inputlabs/alpakka_pcb/alpakka.kicad_pcb

## KiCad design alpakka.kicad_pcb (2023-12-26)

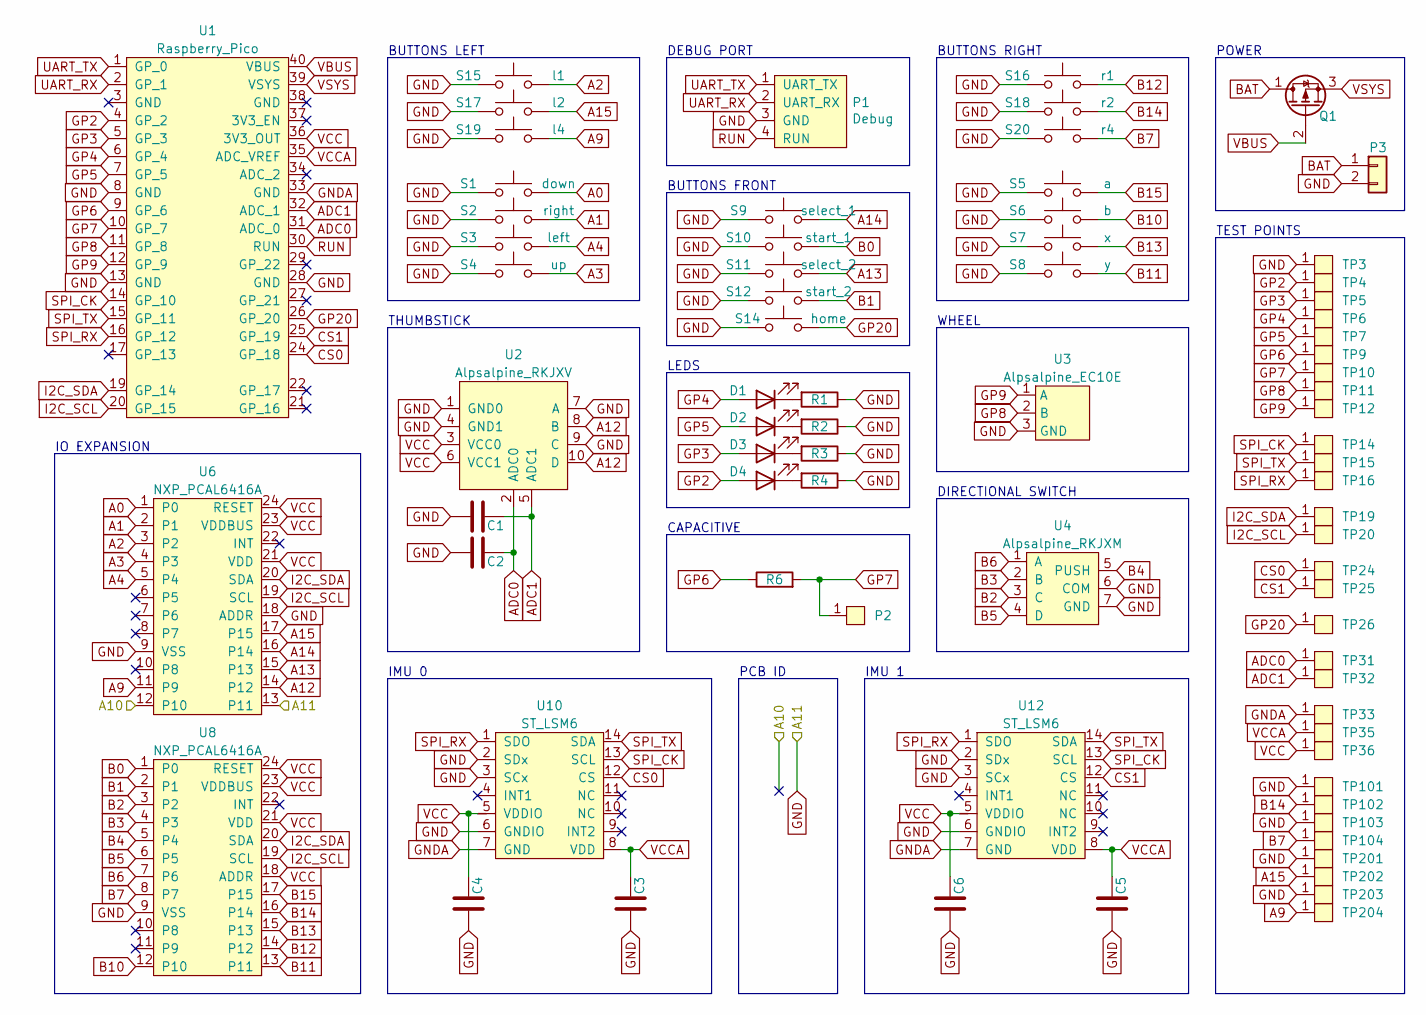
[picture p1: schematic alpakka.kicad_sch]

Parts:
C1, C2, C3, C4, C5, C6: C; 0402; LCSC C1525
D1, D2, D3, D4: Diode; 0603_d; LCSC C2290
P1: Debug; JST_S4B-PH-SM4-K-TB; LCSC C265332
P2: Endpoint; HRO_BC-25-3P; LCSC C707322
P3: Conn_01x02; JST_PH_2_TH
Q1: Q_PMOS_DGS; SOT-23-DGS
R1, R2, R3, R4: R; 0603; LCSC C22950
R6: R6; 0402; LCSC C11616
S1: down; Alpsalpine_SKPM; LCSC C115348
S2: right; Alpsalpine_SKPM; LCSC C115348
S3: left; Alpsalpine_SKPM; LCSC C115348
S4: up; Alpsalpine_SKPM; LCSC C115348
S5: a; Alpsalpine_SKPM; LCSC C115348
S6: b; Alpsalpine_SKPM; LCSC C115348
S7: x; Alpsalpine_SKPM; LCSC C115348
S8: y; Alpsalpine_SKPM; LCSC C115348
S9: select_1; Alpsalpine_SKPM; LCSC C115348
S10: start_1; Alpsalpine_SKPM; LCSC C115348
S11: select_2; Alpsalpine_SKPM; LCSC C115348
S12: start_2; Alpsalpine_SKPM; LCSC C115348
S14: home; Alpsalpine_SKPM; LCSC C115348
S15: l1; Alpsalpine_SKHHL; LCSC C125031
S16: r1; Alpsalpine_SKHHL; LCSC C125031
S17: l2; Alpsalpine_SKQG; LCSC C202424
S18: r2; Alpsalpine_SKQG; LCSC C202424
S19: l4; Alpsalpine_SKQG; LCSC C202424
S20: r4; Alpsalpine_SKQG; LCSC C202424
TP3, TP4, TP5, TP6, TP7, TP9, TP10, TP11, TP12, TP14, TP15, TP16, TP19, TP20, TP24, TP25, TP26, TP31, TP32, TP33, TP35, TP36, TP101, TP102, TP103, TP104, TP201, TP202, TP203, TP204: Endpoint; Pad_1mm
U1: Raspberry_Pico; LCSC C7203002
U2: Alpsalpine_RKJXV; Alpsalpine_RKJXV122400R; LCSC C918854
U3: Alpsalpine_EC10E; LCSC C110291
U4: Alpsalpine_RKJXM; Alpsalpine_RKJXM1015004; LCSC C97432
U6, U8: NXP_PCAL6416A; QFN24; LCSC C2652287
U10, U12: ST_LSM6; LGA14; LCSC C784817

Connections:
/A10: U6.12 (P10)
A0: S1.2, U6.1 (P0)
A1: S2.2, U6.2 (P1)
A2: S15.2, U6.3 (P2)
A3: S4.2, U6.4 (P3)
A4: S3.2, U6.5 (P4)
A9: S19.2, TP204.1, U6.11 (P9)
A12: U2.8 (B), U2.10 (D), U6.14 (P12)
A13: S11.2, U6.15 (P13)
A14: S9.2, U6.16 (P14)
A15: S17.2, TP202.1, U6.17 (P15)
ADC0: C2.2, TP31.1, U1.31 (ADC_0), U2.2 (ADC0)
ADC1: C1.2, TP32.1, U1.32 (ADC_1), U2.5 (ADC1)
B0: S10.2, U8.1 (P0)
B1: S12.2, U8.2 (P1)
B2: U4.3 (C), U8.3 (P2)
B3: U4.2 (B), U8.4 (P3)
B4: U4.5 (PUSH), U8.5 (P4)
B5: U4.4 (D), U8.6 (P5)
B6: U4.1 (A), U8.7 (P6)
B7: S20.2, TP104.1, U8.8 (P7)
B10: S6.2, U8.12 (P10)
B11: S8.2, U8.13 (P11)
B12: S16.2, U8.14 (P12)
B13: S7.2, U8.15 (P13)
B14: S18.2, TP102.1, U8.16 (P14)
B15: S5.2, U8.17 (P15)
BAT: P3.1, Q1.1 (D)
CS0: TP24.1, U1.24 (GP_18), U10.12 (CS)
CS1: TP25.1, U1.25 (GP_19), U12.12 (CS)
GND: C1.1, C2.1, C3.1, C4.1, C5.1, C6.1, P1.3 (GND), P3.2, R1.1, R2.1, R3.1, R4.1, S1.1, S2.1, S3.1, S4.1, S5.1, S6.1, S7.1, S8.1, S9.1, S10.1, S11.1, S12.1, S14.1, S15.1, S16.1, S17.1, S18.1, S19.1, S20.1, TP3.1, TP101.1, TP103.1, TP201.1, TP203.1, U1.8 (GND), U1.13 (GND), U1.28 (GND), U2.1 (GND0), U2.4 (GND1), U2.7 (A), U2.9 (C), U3.3 (GND), U4.6 (COM), U4.7 (GND), U6.9 (VSS), U6.13 (P11), U6.18 (ADDR), U8.9 (VSS), U10.2 (SDx), U10.3 (SCx), U10.6 (GNDIO), U12.2 (SDx), U12.3 (SCx), U12.6 (GNDIO)
GNDA: TP33.1, U1.33 (GND), U10.7 (GND), U12.7 (GND)
GP2: D4.2 (A), TP4.1, U1.4 (GP_2)
GP3: D3.2 (A), TP5.1, U1.5 (GP_3)
GP4: D1.2 (A), TP6.1, U1.6 (GP_4)
GP5: D2.2 (A), TP7.1, U1.7 (GP_5)
GP6: R6.1, TP9.1, U1.9 (GP_6)
GP7: P2.1, R6.2, TP10.1, U1.10 (GP_7)
GP8: TP11.1, U1.11 (GP_8), U3.2 (B)
GP9: TP12.1, U1.12 (GP_9), U3.1 (A)
GP20: S14.2, TP26.1, U1.26 (GP_20)
I2C_SCL: TP20.1, U1.20 (GP_15), U6.19 (SCL), U8.19 (SCL)
I2C_SDA: TP19.1, U1.19 (GP_14), U6.20 (SDA), U8.20 (SDA)
unnamed: D1.1 (K), R1.2
unnamed: D2.1 (K), R2.2
unnamed: D3.1 (K), R3.2
unnamed: D4.1 (K), R4.2
RUN: P1.4 (RUN), U1.30 (RUN)
SPI_CK: TP14.1, U1.14 (GP_10), U10.13 (SCL), U12.13 (SCL)
SPI_RX: TP16.1, U1.16 (GP_12), U10.1 (SDO), U12.1 (SDO)
SPI_TX: TP15.1, U1.15 (GP_11), U10.14 (SDA), U12.14 (SDA)
UART_RX: P1.2 (UART_RX), U1.2 (GP_1)
UART_TX: P1.1 (UART_TX), U1.1 (GP_0)
VBUS: Q1.2 (G), U1.40 (VBUS)
VCC: C4.2, C6.2, TP36.1, U1.36 (3V3_OUT), U2.3 (VCC0), U2.6 (VCC1), U6.21 (VDD), U6.23 (VDDBUS), U6.24 (RESET), U8.18 (ADDR), U8.21 (VDD), U8.23 (VDDBUS), U8.24 (RESET), U10.5 (VDDIO), U12.5 (VDDIO)
VCCA: C3.2, C5.2, TP35.1, U1.35 (ADC_VREF), U10.8 (VDD), U12.8 (VDD)
VSYS: Q1.3 (S), U1.39 (VSYS)

Notes on the sheet:
WHEEL
DEBUG PORT
THUMBSTICK
IMU 0
PCB ID
IMU 1
BUTTONS FRONT
TEST POINTS
DIRECTIONAL SWITCH
CAPACITIVE
IO EXPANSION
LEDS
BUTTONS LEFT
BUTTONS RIGHT
POWER

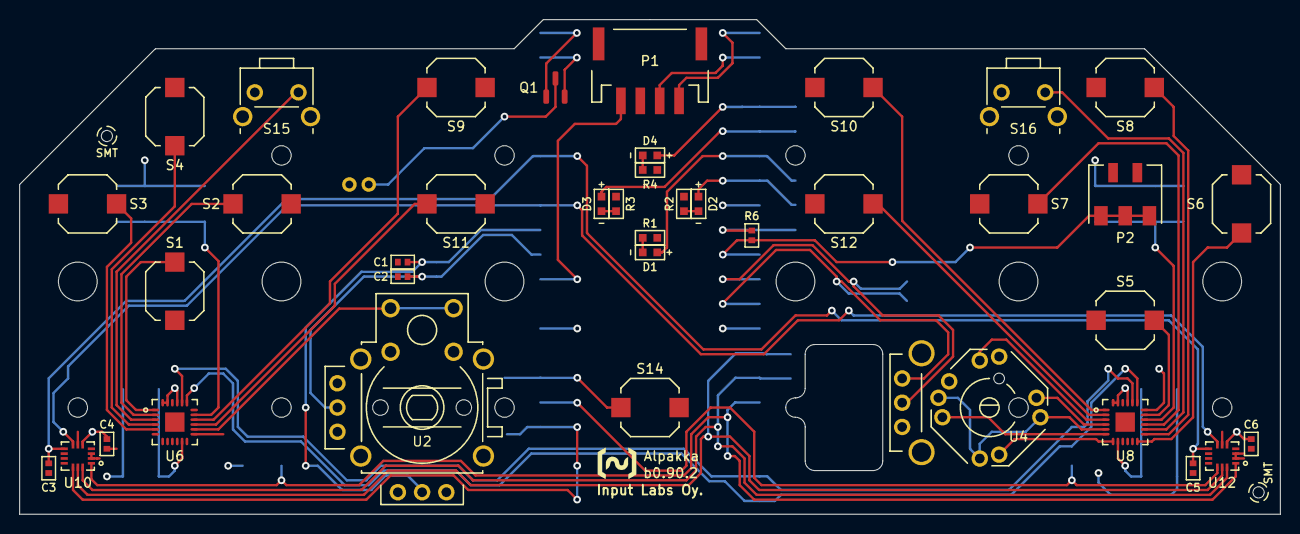
[picture p2: board alpakka.kicad_pcb from above]

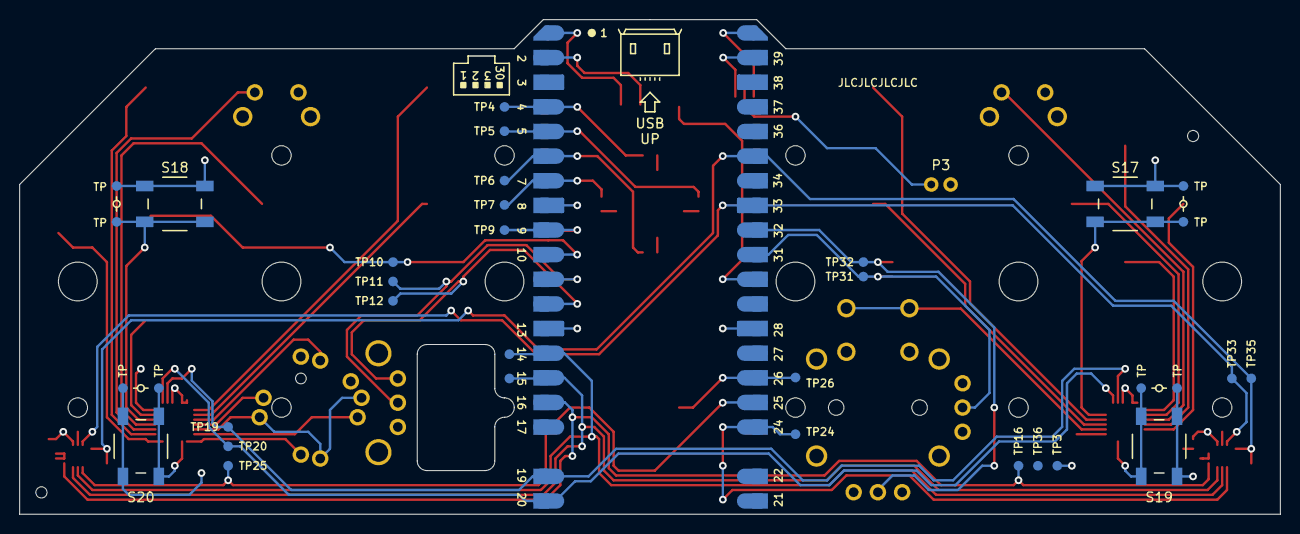
[picture p3: board alpakka.kicad_pcb from below]

Board: 2 copper layers, 130.0 x 51.0 mm, 76 parts (36 on the bottom side), 56 nets.
